shimniok/RoverMux/documentation/images/IMG_0582a.JPG

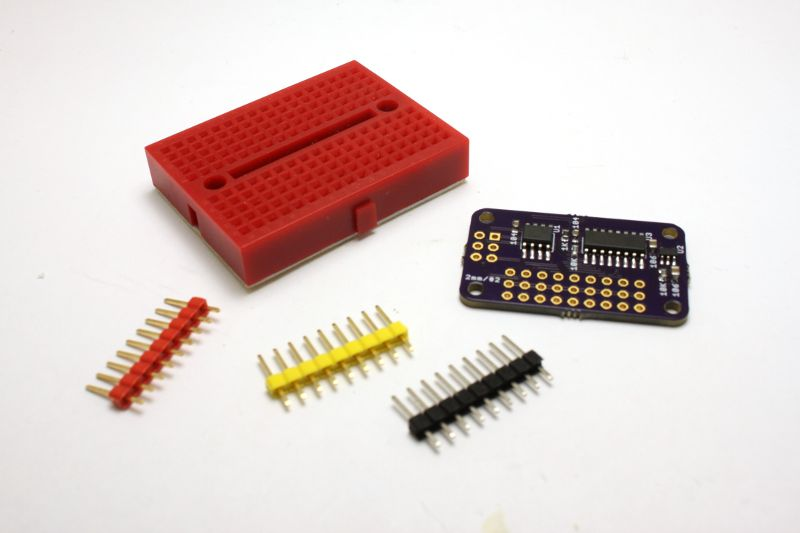
documentation/images/IMG_0582a.JPG
