shimniok/RoverMux/documentation/images/rovermux03.jpg

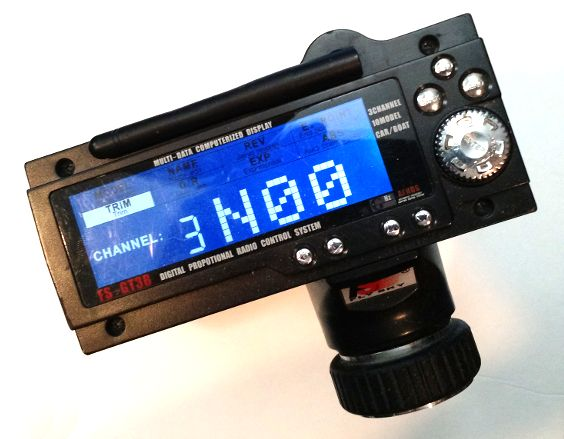
documentation/images/rovermux03.jpg
