shimniok/RoverMux/README.md

RoverMux is an Remote Control multiplexer for use with Autonomous Ground Vehicles (Rovers). With it installed, you can
quickly and easily switch between remote control and autonomous control of your autonomous rover.
