shimniok/RoverMux/documentation/images/IMG_0584a.JPG

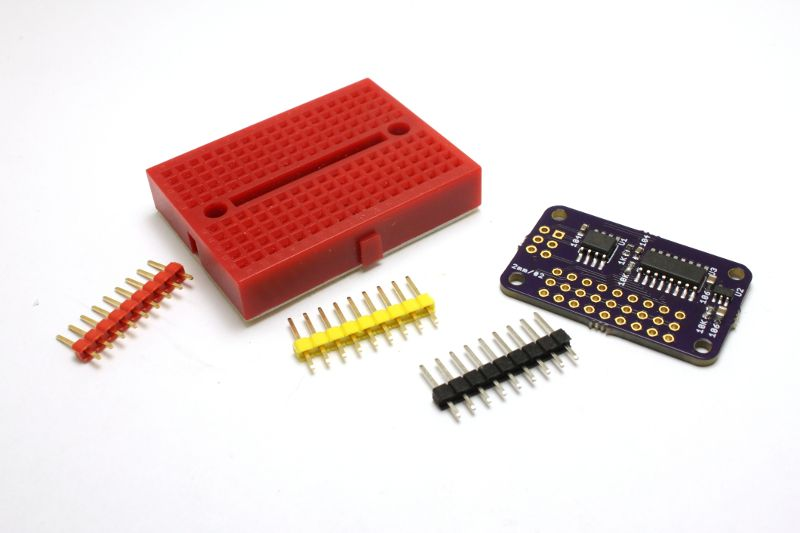
documentation/images/IMG_0584a.JPG
