shimniok/RoverMux/documentation/images/IMG_0586a.JPG

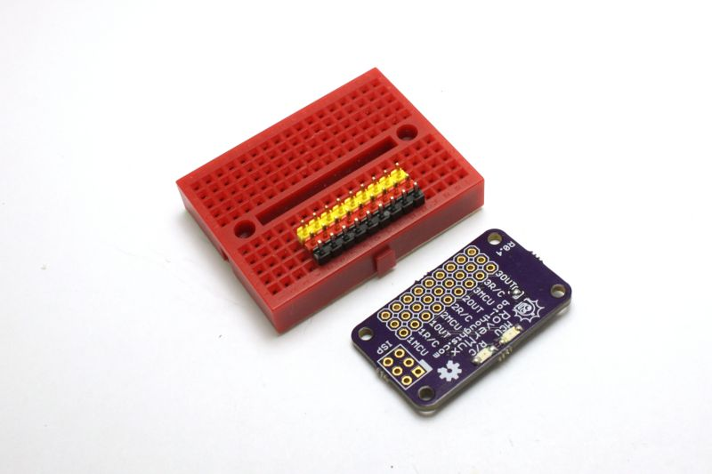
documentation/images/IMG_0586a.JPG
