shimniok/RoverMux/documentation/images/IMG_0587a.JPG

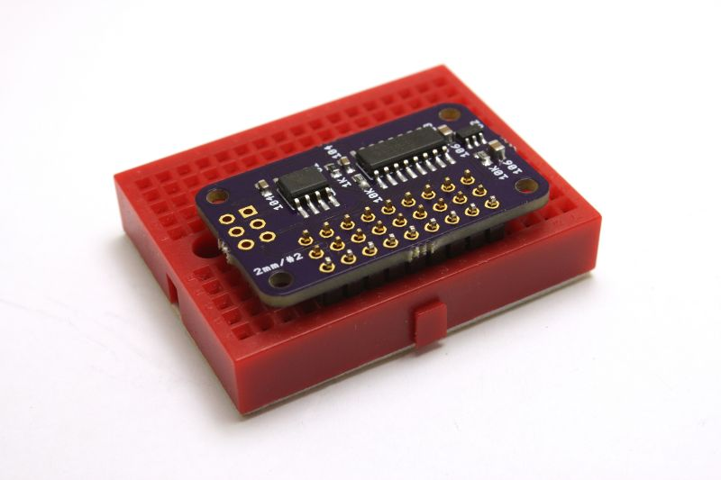
documentation/images/IMG_0587a.JPG
