shimniok/RoverMux/documentation/images/IMG_0588a.JPG

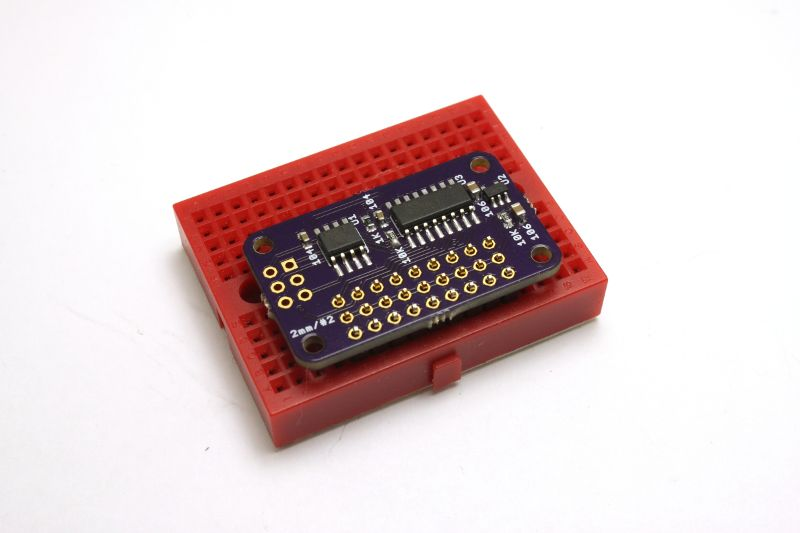
documentation/images/IMG_0588a.JPG
