shimniok/RoverMux/documentation/images/IMG_0590a.JPG

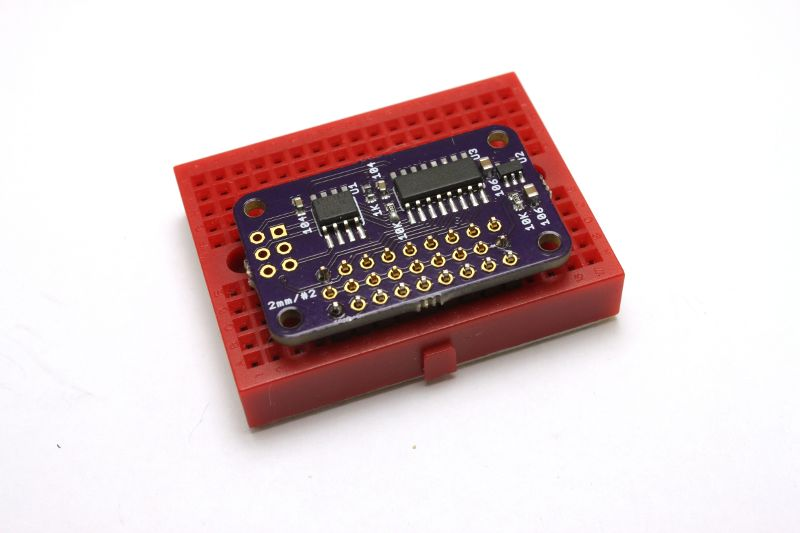
documentation/images/IMG_0590a.JPG
