shimniok/RoverMux/documentation/images/IMG_0591a.JPG

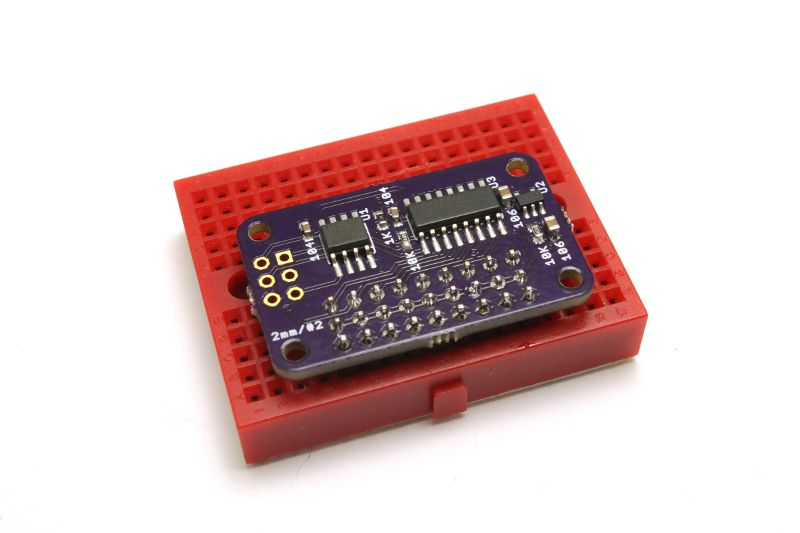
documentation/images/IMG_0591a.JPG
