shimniok/RoverMux/documentation/images/IMG_0597a.JPG

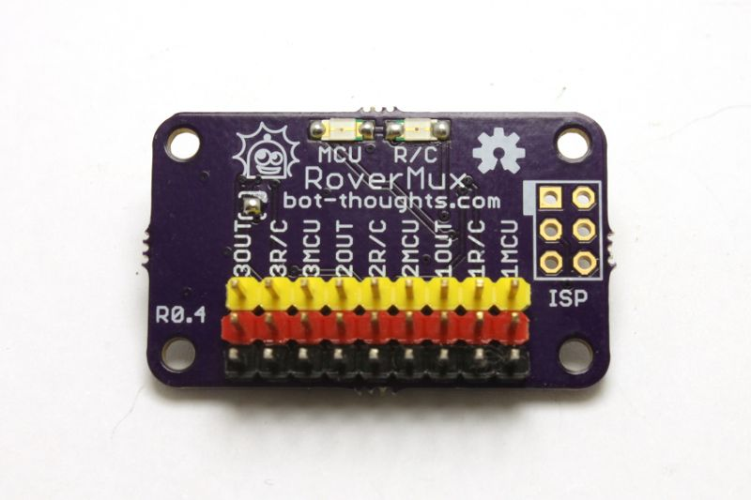
documentation/images/IMG_0597a.JPG
