shimniok/RoverMux/documentation/images/IMG_0607a.JPG

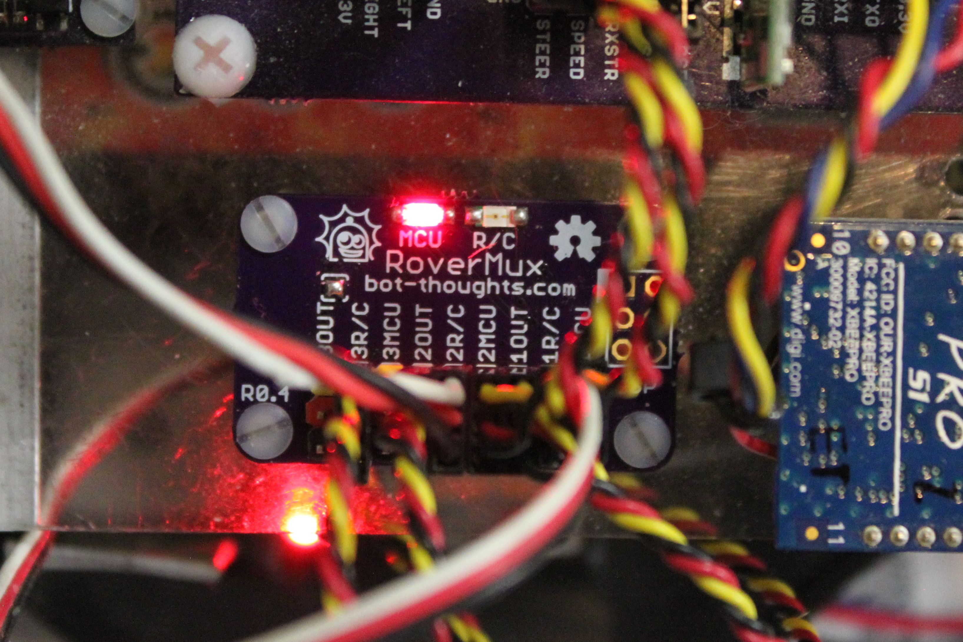
documentation/images/IMG_0607a.JPG
