shimniok/RoverMux/documentation/images/IMG_0608a.JPG

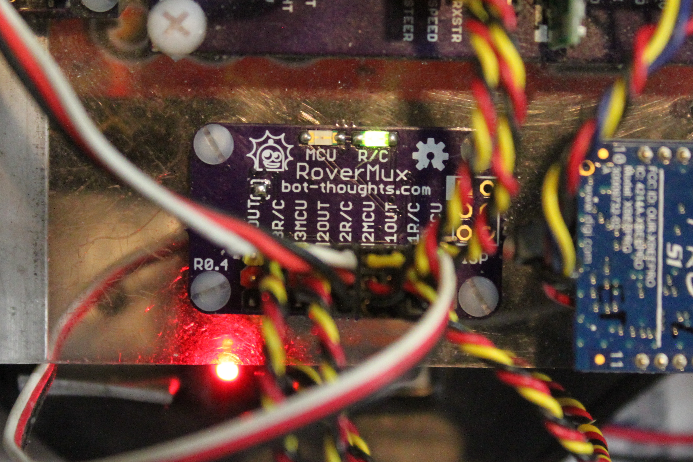
documentation/images/IMG_0608a.JPG
