shimniok/RoverMux/documentation/images/IMG_0609a.JPG

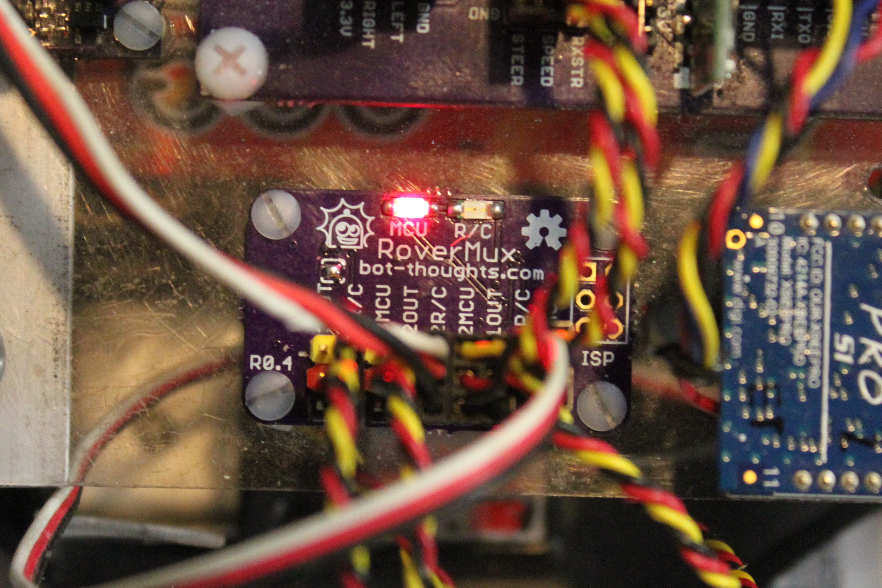
documentation/images/IMG_0609a.JPG
