shimniok/RoverMux/documentation/images/IMG_0613a.JPG

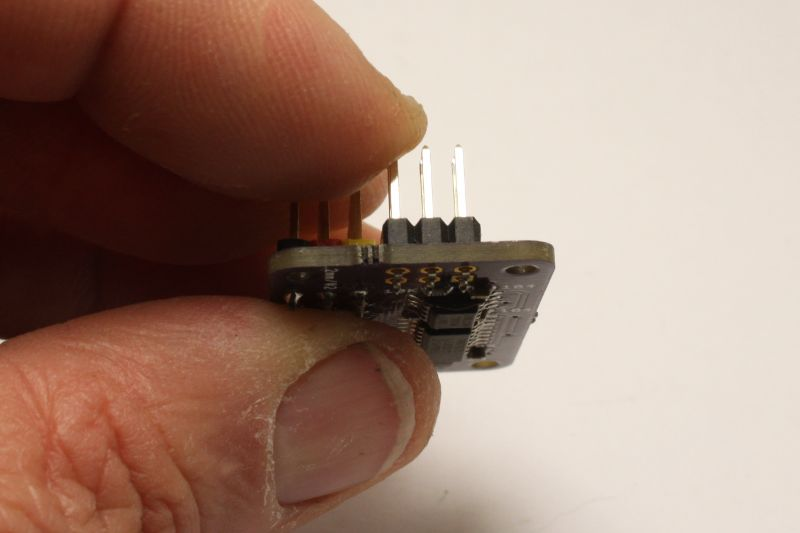
documentation/images/IMG_0613a.JPG
