shimniok/RoverMux/documentation/images/rovermux00.png

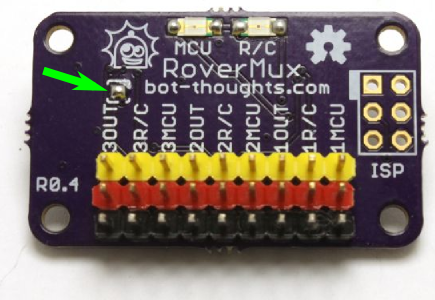
documentation/images/rovermux00.png
