shimniok/RoverMux/documentation/images/rovermux01.jpg

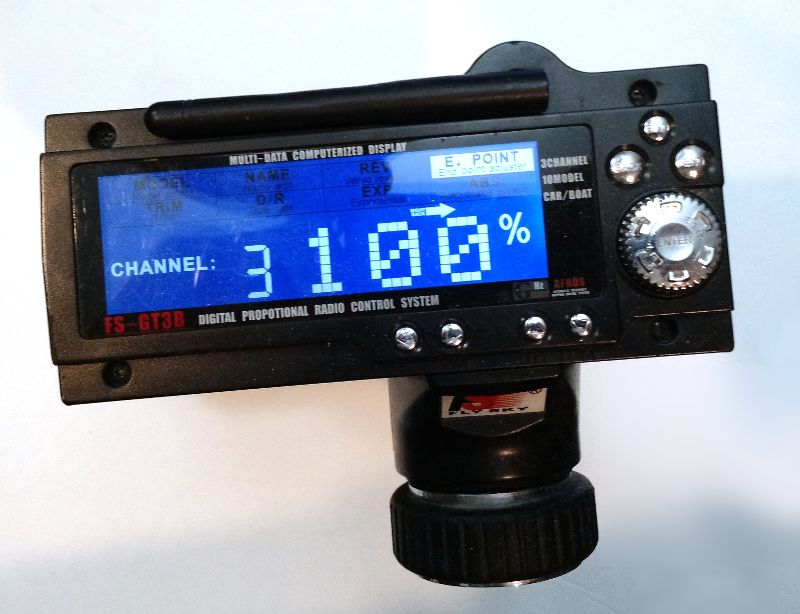
documentation/images/rovermux01.jpg
