shimniok/RoverMux/documentation/images/rovermux02.jpg

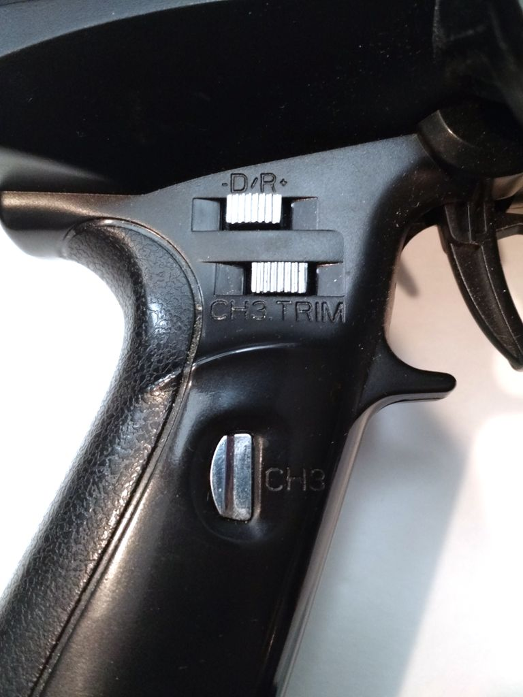
documentation/images/rovermux02.jpg
