shimniok/RoverMux/documentation/images/rovermux04.jpg

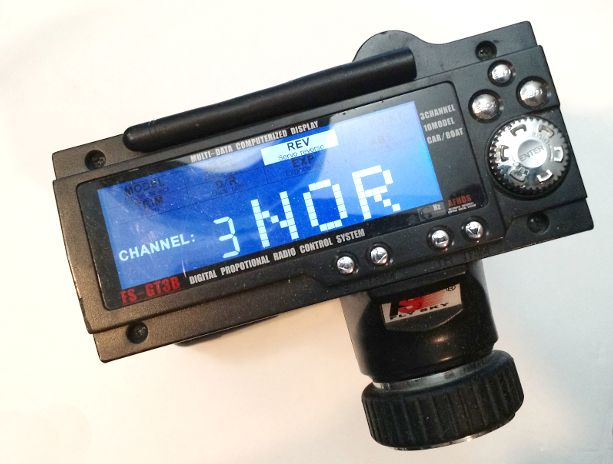
documentation/images/rovermux04.jpg
