shimniok/RoverMux/documentation/images/rovermux06.jpg

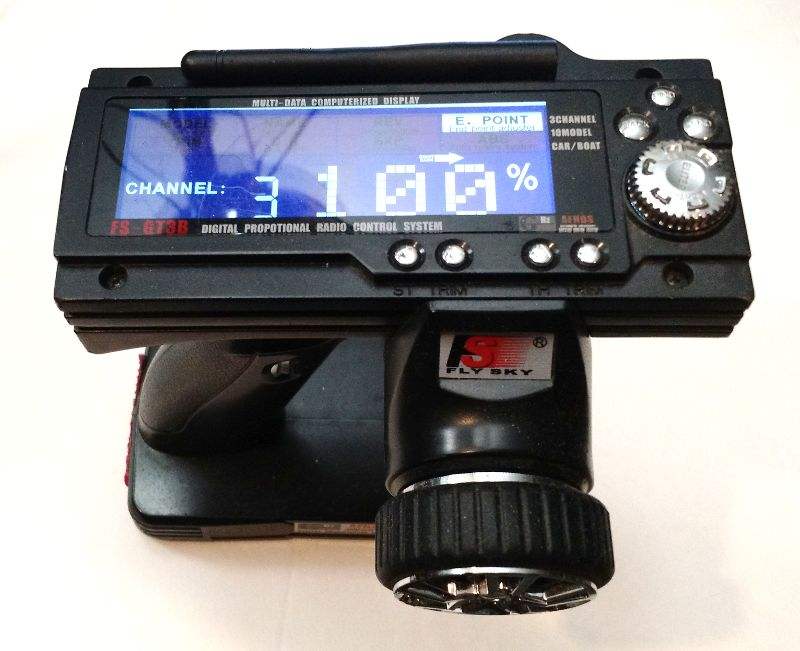
documentation/images/rovermux06.jpg
