shimniok/RoverMux/documentation/images/rovermux08.jpg

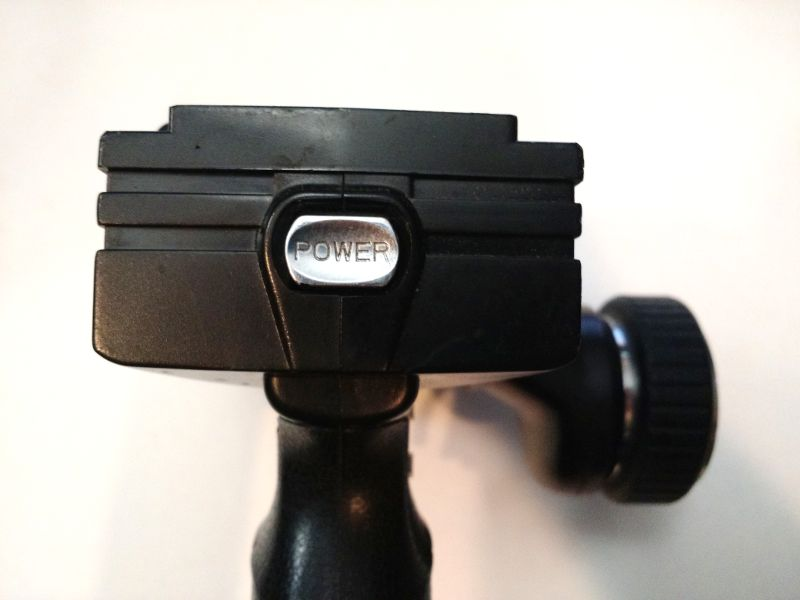
documentation/images/rovermux08.jpg
