shimniok/RoverMux/documentation/images/rovermux09.jpg

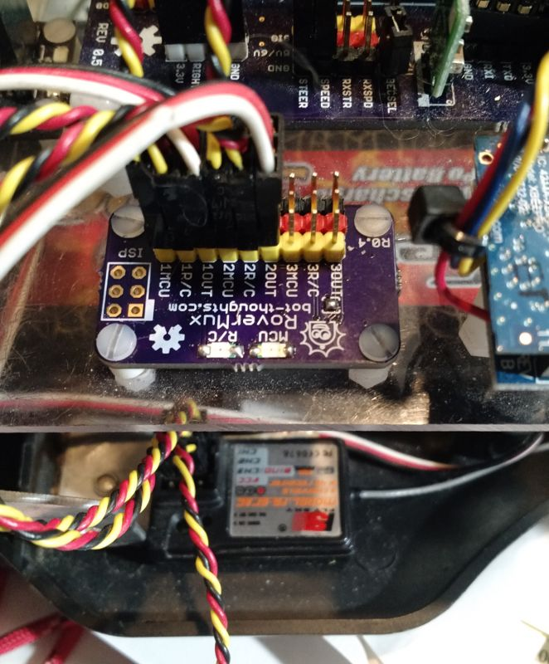
documentation/images/rovermux09.jpg
