shimniok/RoverMux/test/electronics/RoverMuxJig.brd

## EAGLE design test/electronics/RoverMuxJig.brd (2015-10-08)

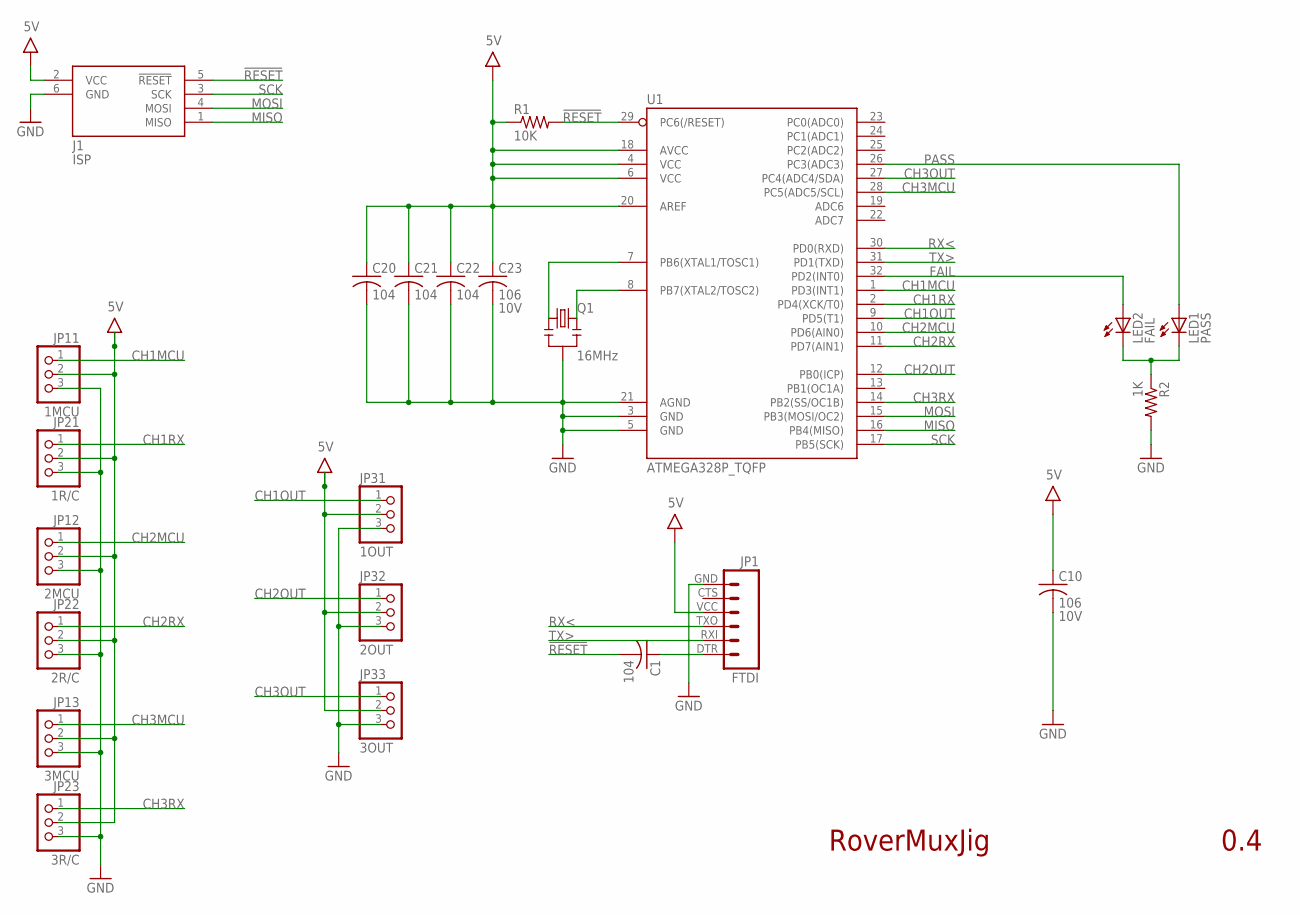
[picture p27: schematic RoverMuxJig.sch]

Parts:
C1, C20, C21, C22: 104; C0603; PARTNO C1608X7R1E104K080AA
C10, C23: 106; C0603; VOLTAGE 10V; PARTNO CL10A106MP8NNNC
J1: ISP; CON6P2R
JP1: FTDI; FTDI_BASIC
JP11: 1MCU; 1X03-S
JP12: 2MCU; 1X03-S
JP13: 3MCU; 1X03-S
JP21: 1R/C; 1X03-S
JP22: 2R/C; 1X03-S
JP23: 3R/C; 1X03-S
JP31: 1OUT; 1X03-S
JP32: 2OUT; 1X03-S
JP33: 3OUT; 1X03-S
LED1: PASS; CHIPLED_1206; PARTNO LH N974-KN-1
LED2: FAIL; CHIPLED_1206; PARTNO LG N971-KN-1
Q1: 16MHz; CSTCE_V_C
R1: 10K; R0603; PARTNO RC0603JR-07330RL
R2: 1K; R0603; PARTNO RC0603JR-07330RL
U1: ATMEGA328P_TQFP; TQFP32-08

Connections:
5V: C10.1, C20.1, C21.1, C22.1, C23.1, J1.2 (VCC), JP1.VCC (4), JP11.2, JP12.2, JP13.2, JP21.2, JP22.2, JP23.2, JP31.2, JP32.2, JP33.2, R1.1, U1.4 (VCC), U1.6 (VCC), U1.18 (AVCC), U1.20 (AREF)
!RESET: C1.2, J1.5 (!RESET), R1.2, U1.29 (PC6(/RESET))
CH1MCU: JP11.1, U1.1 (PD3(INT1))
CH1OUT: JP31.1, U1.9 (PD5(T1))
CH1RX: JP21.1, U1.2 (PD4(XCK/T0))
CH2MCU: JP12.1, U1.10 (PD6(AIN0))
CH2OUT: JP32.1, U1.12 (PB0(ICP))
CH2RX: JP22.1, U1.11 (PD7(AIN1))
CH3MCU: JP13.1, U1.28 (PC5(ADC5/SCL))
CH3OUT: JP33.1, U1.27 (PC4(ADC4/SDA))
CH3RX: JP23.1, U1.14 (PB2(SS/OC1B))
FAIL: LED2.A, U1.32 (PD2(INT0))
GND: C10.2, C20.2, C21.2, C22.2, C23.2, J1.6 (GND), JP1.GND (6), JP11.3, JP12.3, JP13.3, JP21.3, JP22.3, JP23.3, JP31.3, JP32.3, JP33.3, Q1.GND, R2.2, U1.3 (GND), U1.5 (GND), U1.21 (AGND)
MISO: J1.1 (MISO), U1.16 (PB4(MISO))
MOSI: J1.4 (MOSI), U1.15 (PB3(MOSI/OC2))
unnamed: Q1.X2, U1.8 (PB7(XTAL2/TOSC2))
unnamed: Q1.X1, U1.7 (PB6(XTAL1/TOSC1))
unnamed: LED1.C, LED2.C, R2.1
unnamed: C1.1, JP1.DTR (1)
PASS: LED1.A, U1.26 (PC3(ADC3))
RX<: JP1.TXO (3), U1.30 (PD0(RXD))
SCK: J1.3 (SCK), U1.17 (PB5(SCK))
TX>: JP1.RXI (2), U1.31 (PD1(TXD))

Notes on the sheet:
RoverMuxJig
0.4

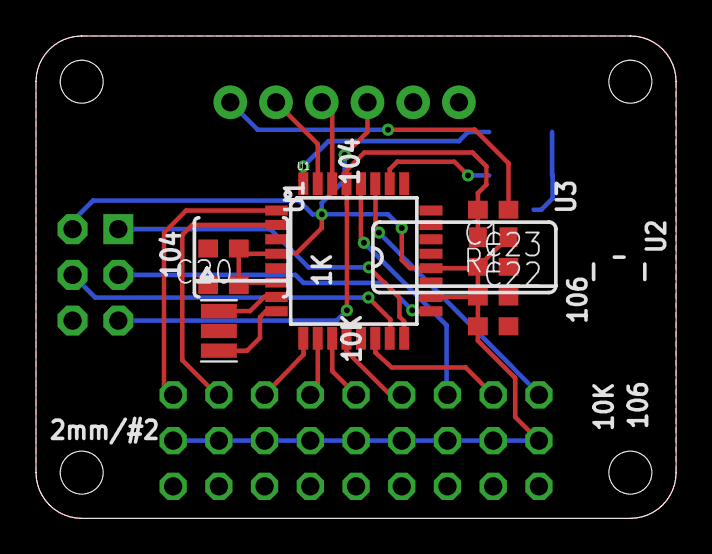
[picture p28: board RoverMuxJig.brd from above]

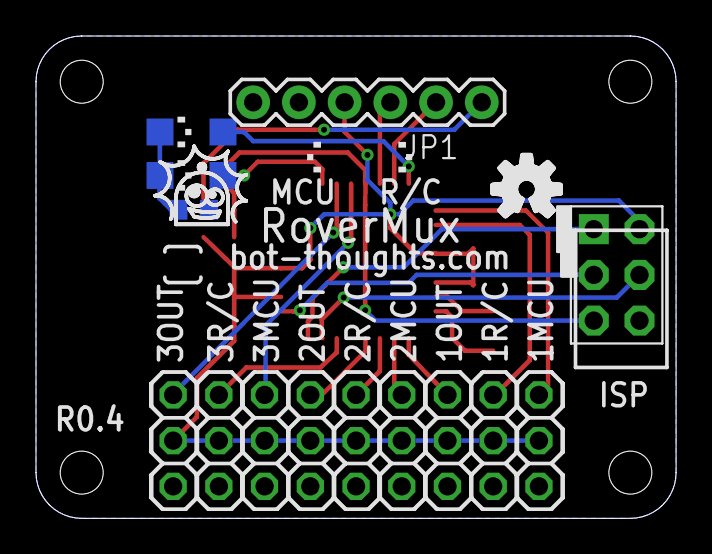
[picture p29: board RoverMuxJig.brd from below]

Board: 2 copper layers, 35.6 x 26.8 mm, 23 parts (14 on the bottom side), 23 nets.
