shimniok/RoverMux/electronics/RoverMux.brd

## EAGLE design electronics/RoverMux.brd (2014-01-29)

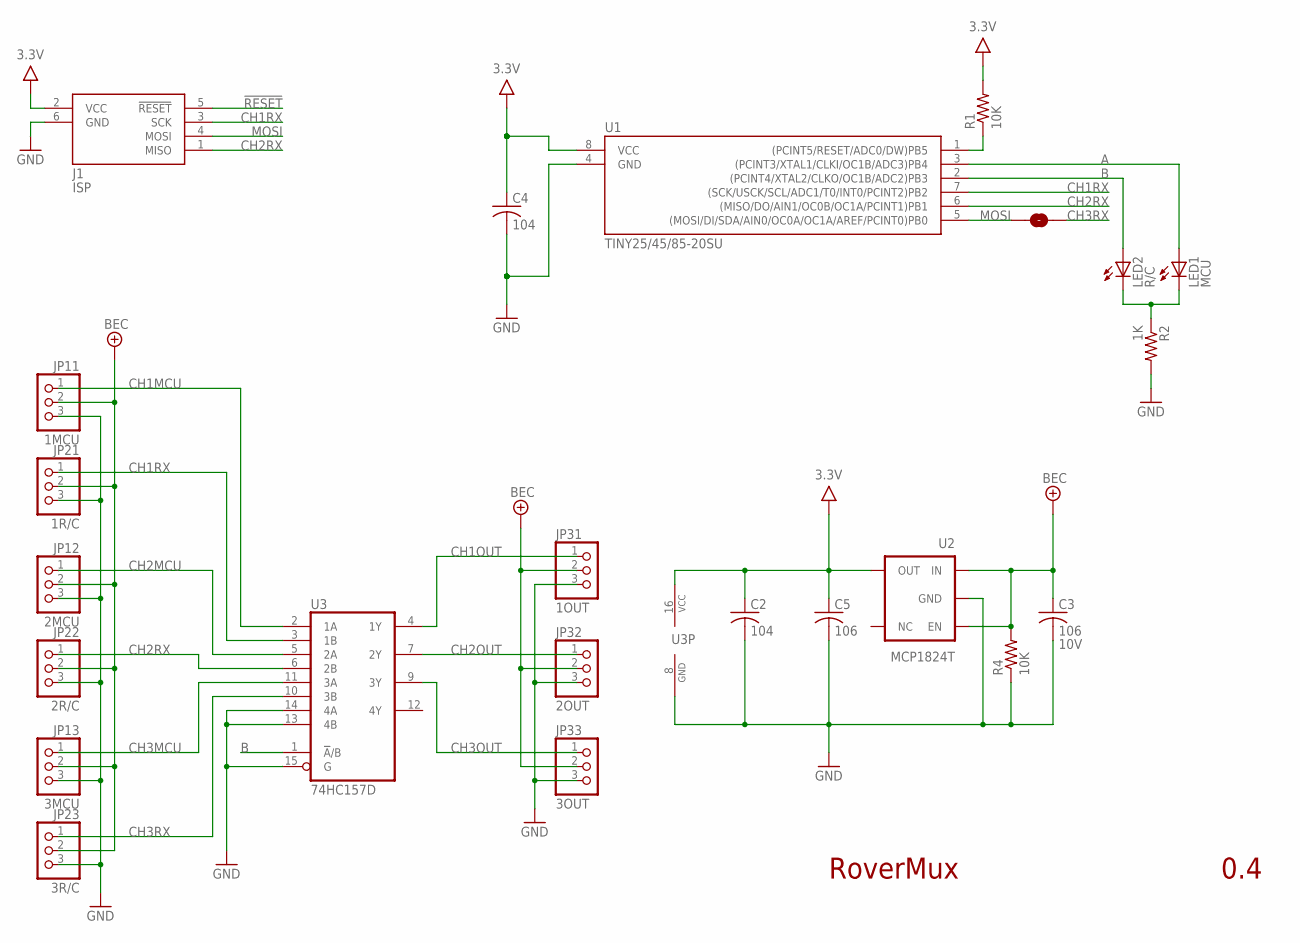
[picture p30: schematic RoverMux.sch]

Parts:
C2, C4: 104; C0603; PARTNO C1608X7R1E104K080AA
C3: 106; C0603; VOLTAGE 10V; PARTNO CL10A106MP8NNNC
C5: 106; C0603; PARTNO CL10A106MP8NNNC
J1: ISP; CON6P2R
JP11: 1MCU; 1X03-S
JP12: 2MCU; 1X03-S
JP13: 3MCU; 1X03-S
JP21: 1R/C; 1X03-S
JP22: 2R/C; 1X03-S
JP23: 3R/C; 1X03-S
JP31: 1OUT; 1X03-S
JP32: 2OUT; 1X03-S
JP33: 3OUT; 1X03-S
LED1: MCU; CHIPLED_1206; PARTNO LH N974-KN-1
LED2: R/C; CHIPLED_1206; PARTNO LG N971-KN-1
R1, R4: 10K; R0603; PARTNO 1622829-1
R2: 1K; R0603; PARTNO RC0603JR-07330RL
SJ1: CH3; SJ_2S-NOTRACE
U1: TINY25/45/85-20SU; SOIC8
U2: MCP1824T; SOT23-5; PARTNO MCP1824T-5002E/OT
U3: 74HC157D; SO16; PARTNO 74HCT157D,652

Connections:
3.3V: C2.1, C4.1, C5.1, J1.2 (VCC), R1.2, U1.8 (VCC), U2.5 (OUT), U3.16 (VCC)
!RESET: J1.5 (!RESET), R1.1, U1.1 ((PCINT5/RESET/ADC0/DW)PB5)
A: LED1.A, U1.3 ((PCINT3/XTAL1/CLKI/OC1B/ADC3)PB4)
B: LED2.A, U1.2 ((PCINT4/XTAL2/CLKO/OC1B/ADC2)PB3), U3.1 (!A!/B)
BEC: C3.1, JP11.2, JP12.2, JP13.2, JP21.2, JP22.2, JP23.2, JP31.2, JP32.2, JP33.2, R4.2, U2.1 (IN), U2.3 (EN)
CH1MCU: JP11.1, U3.2 (1A)
CH1OUT: JP31.1, U3.4 (1Y)
CH1RX: J1.3 (SCK), JP21.1, U1.7 ((SCK/USCK/SCL/ADC1/T0/INT0/PCINT2)PB2), U3.3 (1B)
CH2MCU: JP12.1, U3.5 (2A)
CH2OUT: JP32.1, U3.7 (2Y)
CH2RX: J1.1 (MISO), JP22.1, U1.6 ((MISO/DO/AIN1/OC0B/OC1A/PCINT1)PB1), U3.6 (2B)
CH3MCU: JP13.1, U3.11 (3A)
CH3OUT: JP33.1, U3.9 (3Y)
CH3RX: JP23.1, SJ1.2, U3.10 (3B)
GND: C2.2, C3.2, C4.2, C5.2, J1.6 (GND), JP11.3, JP12.3, JP13.3, JP21.3, JP22.3, JP23.3, JP31.3, JP32.3, JP33.3, R2.2, R4.1, U1.4 (GND), U2.2 (GND), U3.8 (GND), U3.13 (4B), U3.14 (4A), U3.15 (G)
MOSI: J1.4 (MOSI), SJ1.1, U1.5 ((MOSI/DI/SDA/AIN0/OC0A/OC1A/AREF/PCINT0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)
unnamed: LED1.C, LED2.C, R2.1

Notes on the sheet:
RoverMux
0.4

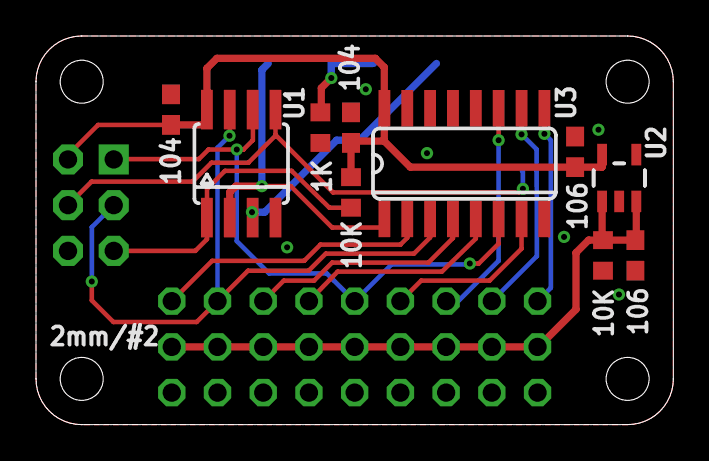
[picture p31: board RoverMux.brd from above]

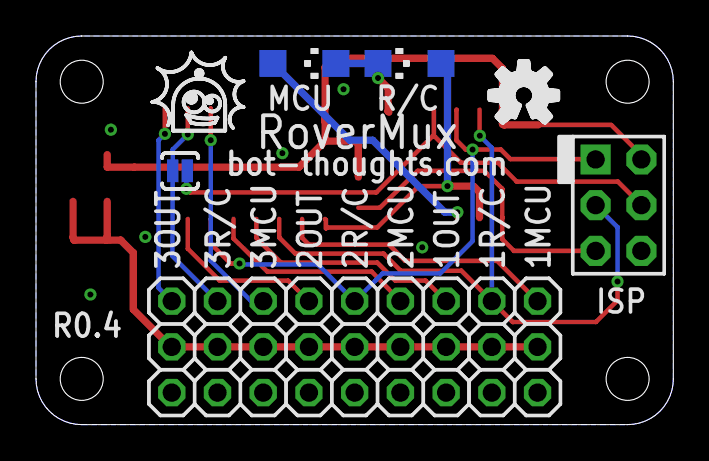
[picture p32: board RoverMux.brd from below]

Board: 2 copper layers, 35.4 x 21.6 mm, 23 parts (13 on the bottom side), 17 nets.
