shimniok/RoverMux/(commit log)

2013-10-01 Consolidated RoverMux electronics and software directories under a single top-level directory
    [RC_MUX.brd, RC_MUX.sch]
2013-10-02 Created RoverMeter for measuring V/A
    [RC_MUX.brd]
2013-10-02 Updated to fix LED indicator circuits, add AVRISP, moved LEDs, rerouted traces.
    [RC_MUX.brd]
2013-10-02 Renamed to RoverMux
    [RoverMux.brd, RoverMux.sch]
2013-10-02 Revised for AVRISP female fitment
    [RoverMux.brd, RoverMux.sch]
2013-10-10 Revised schematic changing LED indicator circuit to fix design flaw.
    [RoverMux.sch]
2013-11-04 RoverMux electronics changes, minor software changes
    [RoverMux.brd, RoverMux.sch]
2014-01-29 Revised 8SOIC footprint, replaced 5V regulator and selector with 3.3V regulator to simplify. Moved devices around, simplified routing to pin headers. Placed missing ISP trace. Revised schematic layou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
    [RoverMux.brd, RoverMux.sch]
2014-01-29 Added silkscreen, version 0.4 as ordered.
    [RoverMux.brd, RoverMux.sch]
2015-10-06 Added test jig
    [RoverMuxJig.brd, RoverMuxJig.sch]
2015-10-08 basic servo signals and data structures
2015-10-08 Revised variable names, consolidated servoon/off into servoSet.
2015-10-08 Attempt to manually control servo outputs and inputs
2015-10-08 Updated jig
    [RoverMuxJig.brd, RoverMuxJig.sch]
2015-10-08 moved eagle files to subdir
    [RoverMuxJig.brd, RoverMuxJig.sch]
2015-10-09 Initial attempt to set up servo signal pin timing
2015-10-09 Implemented timer check for CH1OUT, one test case
2015-10-09 monitoring multiple tests, multiple channels. possible bug with ch3 monitoring?
    [inservo.ino, muxtest.ino]
2015-10-09 fixed issues with counter resets resulting in incorrect duration counts
    [inservo.ino, muxtest.ino]
